Daniel-Wait/EDesign344/README.md

# EDesign344 Analog Electronics

Power Monitoring System.

3rd Year, 2nd semester design project. Read "./Reports/Wait_20887507_A3.pdf" for further details.
