Daniel-Wait/EDesign344/Reports/DanielWait_20887507_Ass2.pdf

## Report for E-design 344

by

## DB Wait

20887507

E-Design report # 2

September 2019

# Declaration

By submitting this report electronically, I declare that the entirety of the work contained therein is my own, original work, that I am the sole author thereof (save to the extent explicitly otherwise stated), that reproduction and publication thereof by Stellenbosch University will not infringe any third party rights and that I have not previously in its entirety or in part submitted it for obtaining any qualifcation.

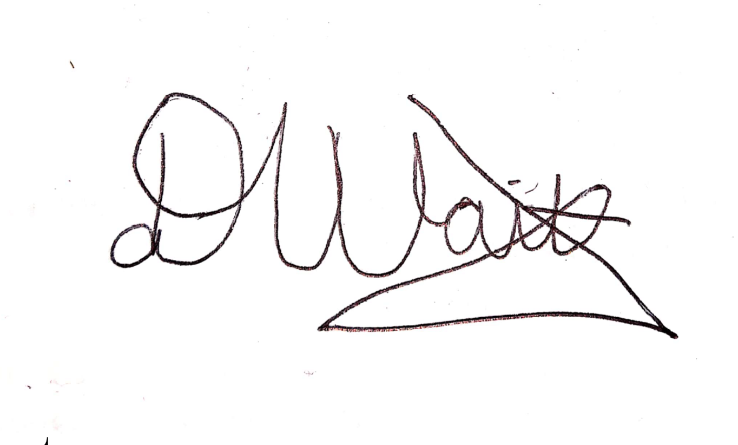
[picture p1: figure]

Signature: | D.B. Wait
Date: |

i

23/09/2019

# Contents

Declaration | i
Contents | ii
List of Figures | iii
1 Signal conditioning system design | 1
2 Voltage peak transducer | 2
3 Current peak transducer | 7
4 Phase shift transducer | 12
5 System tests | 15
References | 17
Appendix A: GitHub Activity Heatmap | 18

ii

# List of Figures

1.1 | System diagram | | 1
2.1 | Voltage Transducer circuit | | 3
2.2 | Voltage Transducer Circuit | | 4
2.3 | Emulated Voltage Transducer tests | | 5
2.4 | Voltage Transducer: Linear function of analogue output vs input voltage 5
2.5 | Integrated test of voltage transducer | | 5
2.6 | Oscilloscope measurement of analogue DC output and AC character-
| istics of the Voltage Transducer for the Mid-range load | | 6
3.1 | Current Transducer circuit | | 7
3.2 | Current transducer LTSpice results | | 9
3.3 | Emulated Voltage Transducer tests | | 9
3.4 | Current Transducer: Linear function of analogue output vs. load current 10
3.5 | Integrated test of the current transducer | | 10
3.6 | Oscilloscope measurement of analogue DC output and AC character-
| istics of the Current Transducer for the Mid-range load | | 11
4.1 | Phase Transducer circuit | | 12
4.2 | LTSpice simulations results | | 13
4.3 | Integrated test of the phase shift transducer | | 14
4.4 | Oscilloscope measurement of analogue DC output and AC character-
| istics of the Phase Transducer for the Mid-range load | | 14
5.1 | Integrated test of the current transducer | | 15
5.2 | Oscilloscope measurements of rails at Full Load Condition | | 16

iii

# Chapter 1

# Signal conditioning system design

The colour-coded block diagram as shown in Figure 1.1 represents the design of the system to transduce the peak voltage (blue) and peak current (yellow) through a load, as well as the absolute phase-shift between them (green). The design is required to measure: an input voltage between 12 VAC to 20 VAC; a current through the load of 0 mA to 285 mA; and an absolute phase-shift of 0° to 45°. Each transducer’s output shall be represented on a 0 V to 5 V, 10-bit ADC.
The 5 V and −5 V rails from Assignment 1 are designed to output at least 50 mA. The system uses 7 TLC2272 op-amps and a TL081 op-amp resulting in a maximum current consumption of 23.8 mA. Therefore, the rails should work.

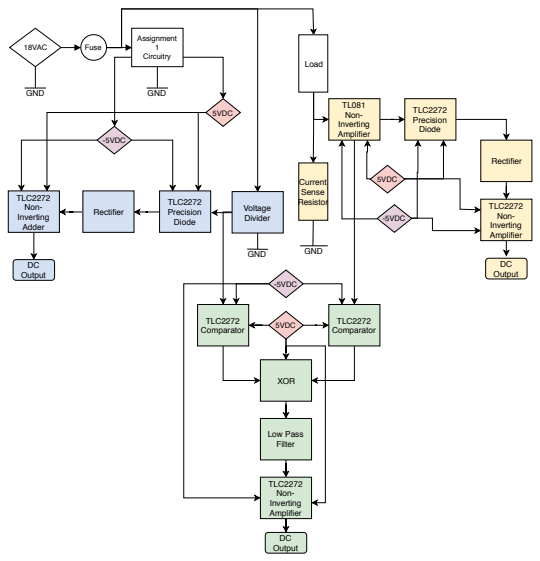
[picture p2: figure]
TLC2272 Precision Diode; Rectifier; TLC2272 Non- Inverting Amplifier; DC Output; 18VAC; Fuse; Assignment 1 Circuitry; GND; 5VDC; -5VDC; TL081 Non- Inverting Amplifier; Load; Current Sense Resistor; Voltage Divider; TLC2272 Non- Inverting Adder; TLC2272 Comparator; XOR; Low Pass Filter

Figure 1.1: System diagram

1

# Chapter 2

# Voltage peak transducer

## 2.1 Theory and related work

In order to transform an AC voltage into a DC voltage output, rectification will be necessary. A simple half-wave rectifier would use a 1N4007 rectifying diode which has a forward-voltage of 1.1 V [1, p.2]. In order to induce a negligible voltage drop over the diode, a ’precision-diode’ configuration is used. The precision-diode functions by using the diode’s cathode as feedback to the op-amp such that the output of the precision-diode matches the positive cycle of the input voltage [2, p.

654] and Vin+ = Vin− = Vout.
For a half-wave rectifier, the Equation 2.1 can be used to calculate the RC constant (τ ) for given parameters [2, p.76]. It is important to note that multiplication of VL and VM by the same factor has no affect on τ .

VL = VMe

−t/τ | (2.1)

This project also implements a non-inverting summing amplifier with two inputs. The output of such a configuration is to be calculated with the following equation [3]:

Vout = (1 + Rf
Rg

)(V1

Rin2

Rin1 + Rin2

+ V1

Rin1

Rin1 + Rin2

) | (2.2)

The supply voltage from the transformer regularly exceeds 18 VAC and may be up to 22 VAC for the no-load condition. Hence, the design parameters have been adjusted for a range of 12 VAC to 23 VAC.

## 2.2 Design

Figure 2.1 is the product of the design choices below.

2

CHAPTER 2. VOLTAGE PEAK TRANSDUCER | 3

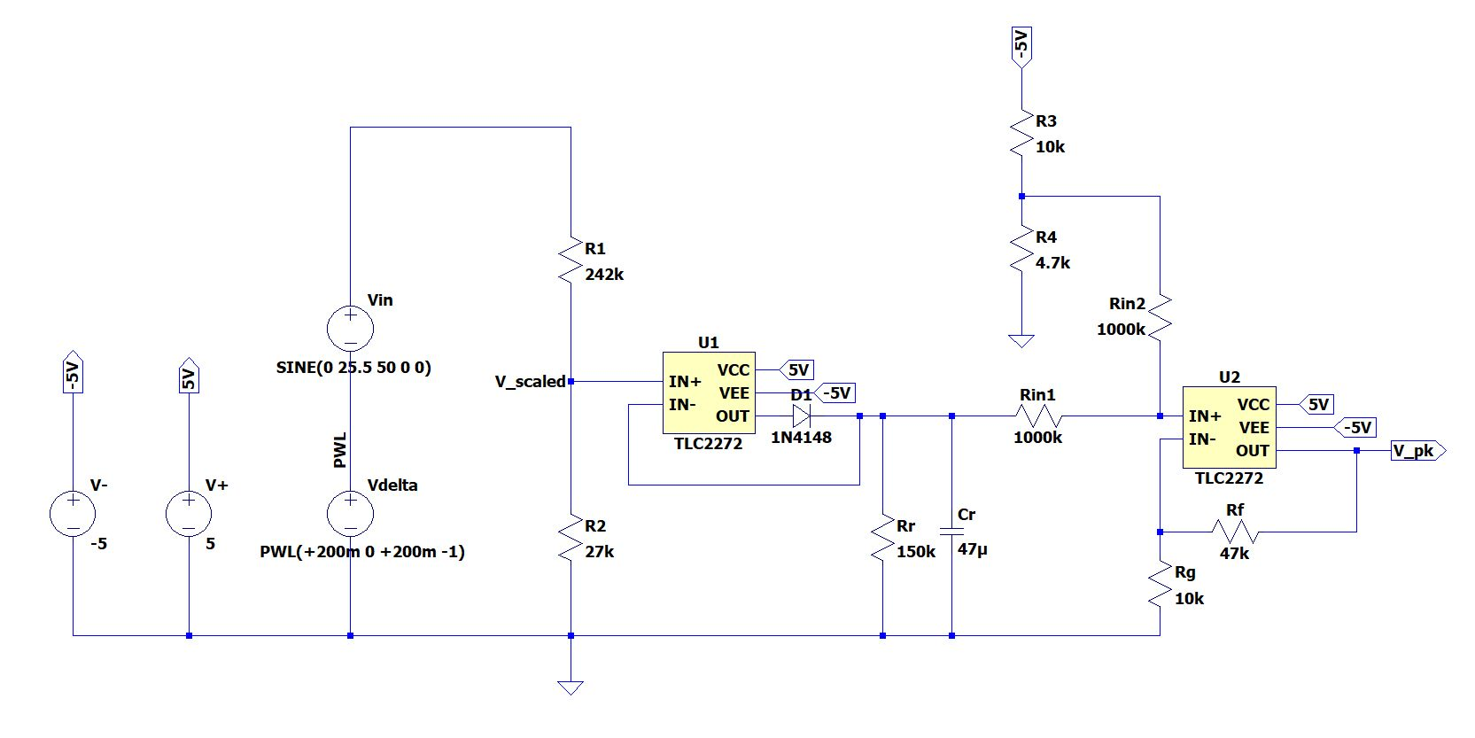
[picture p3: figure]

Figure 2.1: Voltage Transducer circuit

Firstly, the input AC voltage is divided with high-impedance resistors. This scaled voltage is input to the precision diode. To account for the maximum common-mode voltage of the TLC2272, the scaled voltage may be no more than 3.5 V. The transformer output may be as large as 31 Vpk, hence I chose to scale down the input voltage by a factor of 10 so that the common-mode limit will not be exceeded.

1
10 =

R2
R1+R2
Choosing R2 = 27 kΩ to ensure a high series impedance, R1 = 243 kΩ which can be approximated with a series combination of 220 kΩ and 22 kΩ resistors.

Secondly, the scaled voltage is half-wave rectified. The rectified signal ripple must meet the 150 mV accuracy requirement while preserving the ability to detect a 1 V change at the input within one second. Using the given Equation 2.1, the minimum value of τ can be determined such that a 23 VAC drops by 150 mV over a 20 ms period:

τmin =

−0.02
ln( ²³√
2−0.15
23√
2

)

= 4.33

Similarly, for a minimum voltage of 16 VAC, to detect a 1 V decrease within 1 s, the maximum value of τ can be calculated:

τmax =

−1
ln( ¹⁶√
2−1
16√
2

)

= 22.12

Therefore, a resistor of 150 kΩ and a capacitor of 47 µF results in an acceptable τ = RC = 7.05.

CHAPTER 2. VOLTAGE PEAK TRANSDUCER | 4

Finally, the rectified signal is passed to a non-inverting summing amplifier [3] which scales the voltage such that the original input of 12 VAC to 23 VAC lies within a range of 0 VDC to 5 VDC.
The amplifier takes the rectified signal and a DC offset as the inputs - both input resistances are 1 MΩ for simplicity. The negative rail is used to create an offset at the second input of the amplifier such that 12 VAC translates to 0 V. Thus, the negative rail divided with resistors (R3 and R4) to match an input of 12 VAC (divided and rectified to 1.7 V).
The gain of the non-inverting adder is designed so that 23 VAC represents at most 4.85 V in compliance with the minimum high-level output voltage of the TLC2272 for low currents [4, p.7]. Therefore, a gain of 5.7 is chosen with Rf = 47 kΩ and Rg = 10 kΩ

## 2.3 Simulation

The design was validated with an LTSpice simulation to ensure that the design requirements are met. Figure 2.2 is the result of the simulation of the circuit in Figure 2.1. The graphic depicts the scaled voltage, input voltage decrements, and DC voltage output of the voltage transducer for an 18 VAC input.

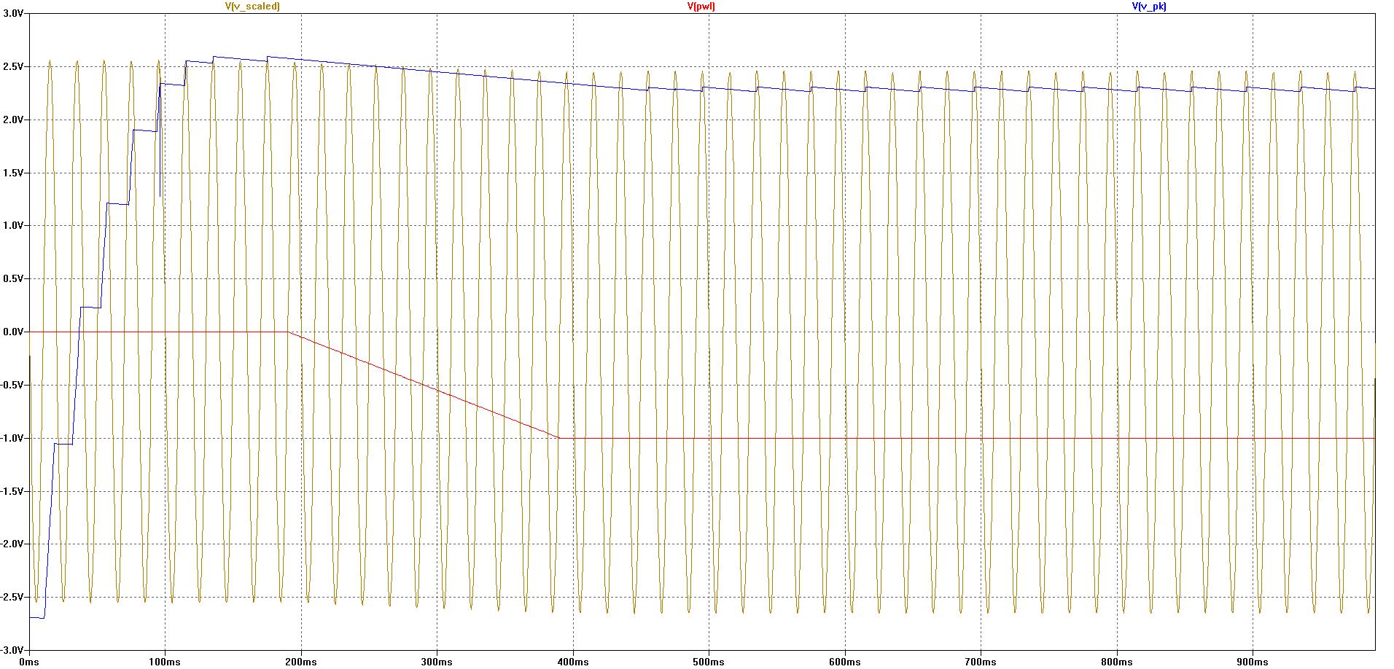
[picture p4: figure]

Figure 2.2: Voltage Transducer Circuit

## 2.4 Measurements

The design was rigorously tested with emulated input voltages in order to determine the accuracy of the deduced input from the analogue output. The deduced input

CHAPTER 2. VOLTAGE PEAK TRANSDUCER | 5

column is calculated from the circuit design to demonstrate the deviation from the expected output.

Figure 2.3: Emulated Voltage Transducer tests

Table 2.3 was used to generate an accurate linear model as shown in Figure 2.4. This model is to be used in the integrated test’s calculation.

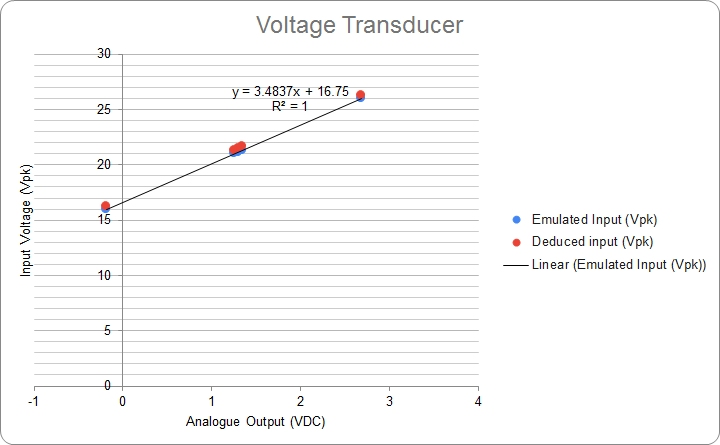
[picture p5: figure]

Figure 2.4: Voltage Transducer: Linear function of analogue output vs input voltage

The integrated test in Figure 2.5 verifies that inaccuracies in the output can be compensated for with the above linear equation.

Figure 2.5: Integrated test of voltage transducer

CHAPTER 2. VOLTAGE PEAK TRANSDUCER | 6

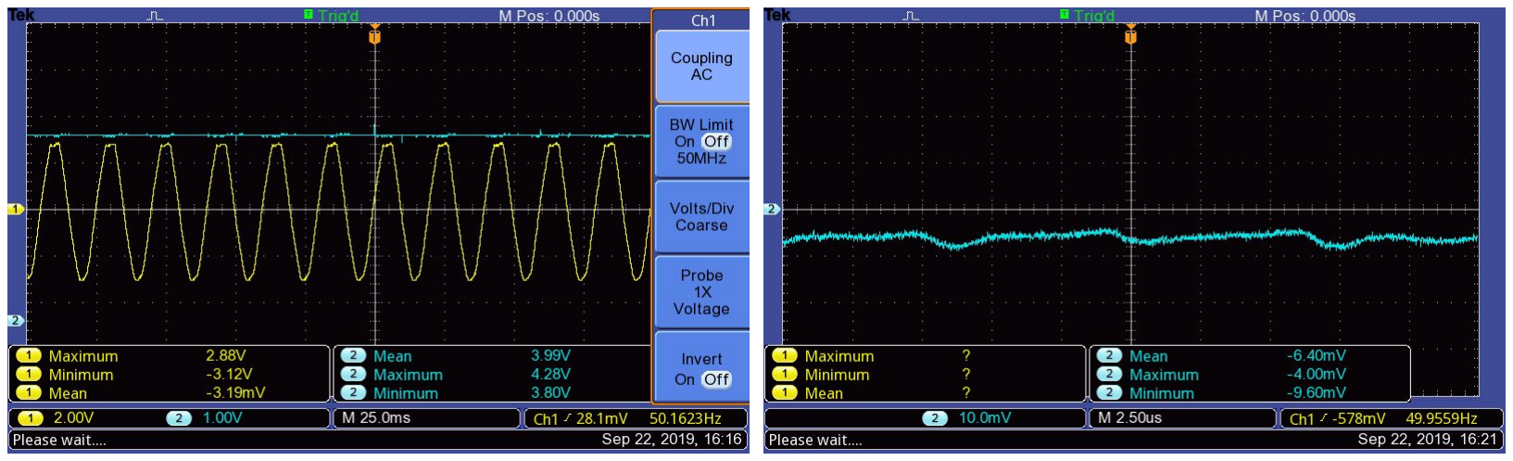
[picture p6: figure]

(a) VAC Input and DC output | (b) Voltage transducer AC output

Figure 2.6: Oscilloscope measurement of analogue DC output and AC characteristics of the Voltage Transducer for the Mid-range load

# Chapter 3

# Current peak transducer

## 3.1 Theory and related work

The current transducer design is quite similar to that of the voltage transducer, due to the nature of transforming an AC signal into a DC representation. Once again, the precision rectifier, equation 2.1, and a precision diode will be used.
A simple, non-inverting amplifier configuration, the gain is calculated as follows:

Av = (1 + Rf
Rg
) | (3.1)

For such configurations, the maximum common-mode voltage is unlikely to be exceeded due to the fact that Vin−max = VOH

Rg
Rf+Rg .
TL081 op-amps have a better Common-Mode Rejection Ratio (CMRR) than that of a TLC2272 [5, p.7] [4, p.7]. Therefore, the TL081 makes for a better smallsignal amplifier [6].

## 3.2 Design

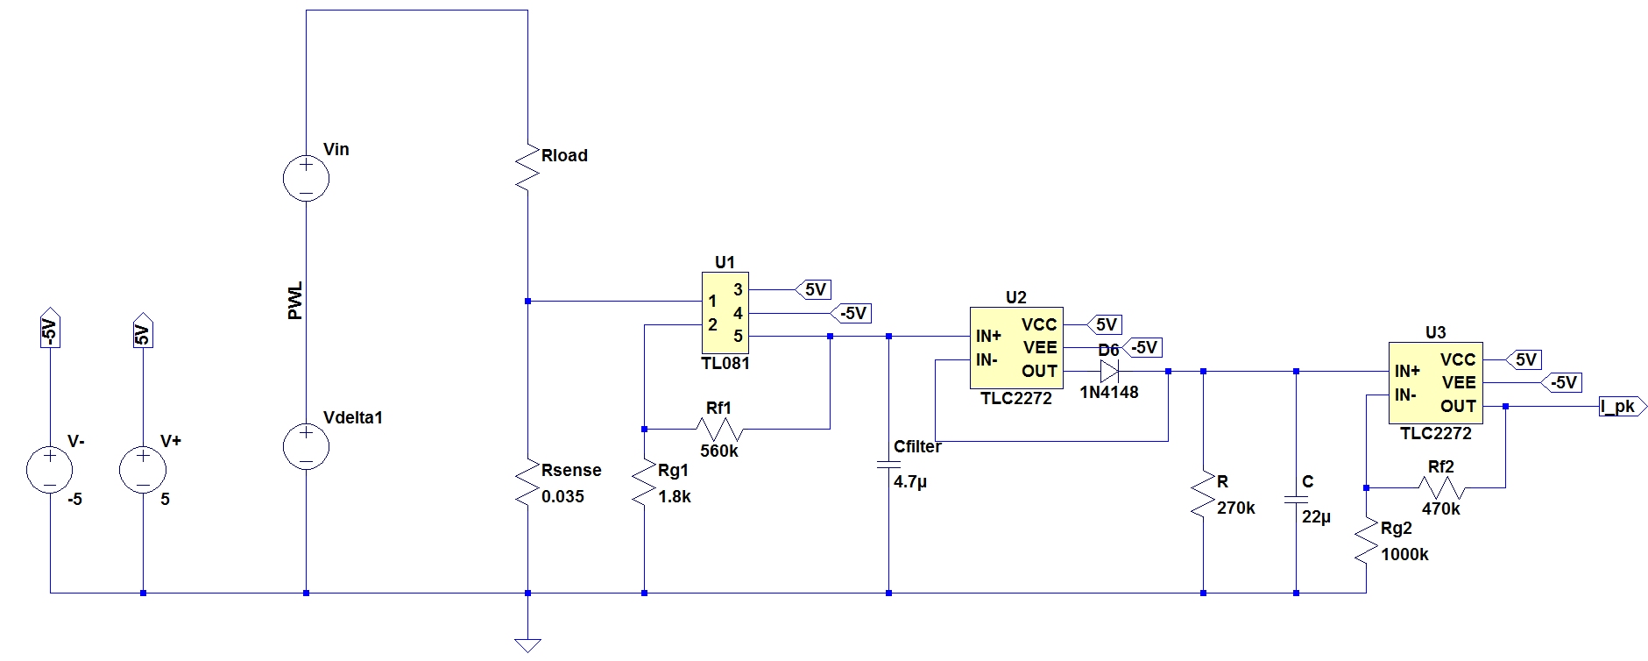
[picture p7: figure]

Figure 3.1: Current Transducer circuit

7

CHAPTER 3. CURRENT PEAK TRANSDUCER | 8

30 mΩ and 5 mΩ current-sense resistors are connected in series to maximize the small voltage which is pre-amplified by the TL081 op-amp. For a maximum current of 285 mA (VRsense = 9.975 mV), the voltage gain is required to comply with the TL081 minimum high-level output voltage of 3.5 V [5, p.9]. A gain of 312 is set by choosing Rf1 = 560 kΩ and Rg1 = 560 kΩ.
The pre-amplified voltage is half-wave rectified. The precision diode ensures negligible voltage drop. The rectified signal ripple must meet the 1 mA accuracy requirement and be able to detect a 10 mA change in current for currents over 100 mA within one second.
The maximum value of τ can be determined such that a 285 mA drops by 1 mA over a 20 ms period:

τmin =

−0.02
ln( ²⁸⁵⁻¹
285 )

= 5.69

Similarly, for a minimum current of 100 mA, to detect a 10 mA decrease within 1 s, the maximum value of τ can be calculated:

τmax =

−1
ln( ¹⁰⁰⁻¹⁰
100 )

= 9.49

Therefore, a resistor of 270 kΩ and a capacitor of 22 µF results in an acceptable τ = RC = 5.94.

The rectified signal is post-amplified by a non-inverting amplifier such that 285 mA through the sensing resistor will output closer to the 5 V limit. Hence, for a configuration of Rf2 = 470 kΩ and Rg2 = 1 MΩ, the gain is 1.47 and an input of 285 mA should be converted to 4.58 V.

## 3.3 Simulation

An LTSpice simulation of the circuit in Figure 3.1 indicates that the current transducer satisfies the specifications. The input voltage is chosen to demonstrate that the chosen RC constant allows a 10 mA change to be detected for currents above 100 mA.

CHAPTER 3. CURRENT PEAK TRANSDUCER | 9

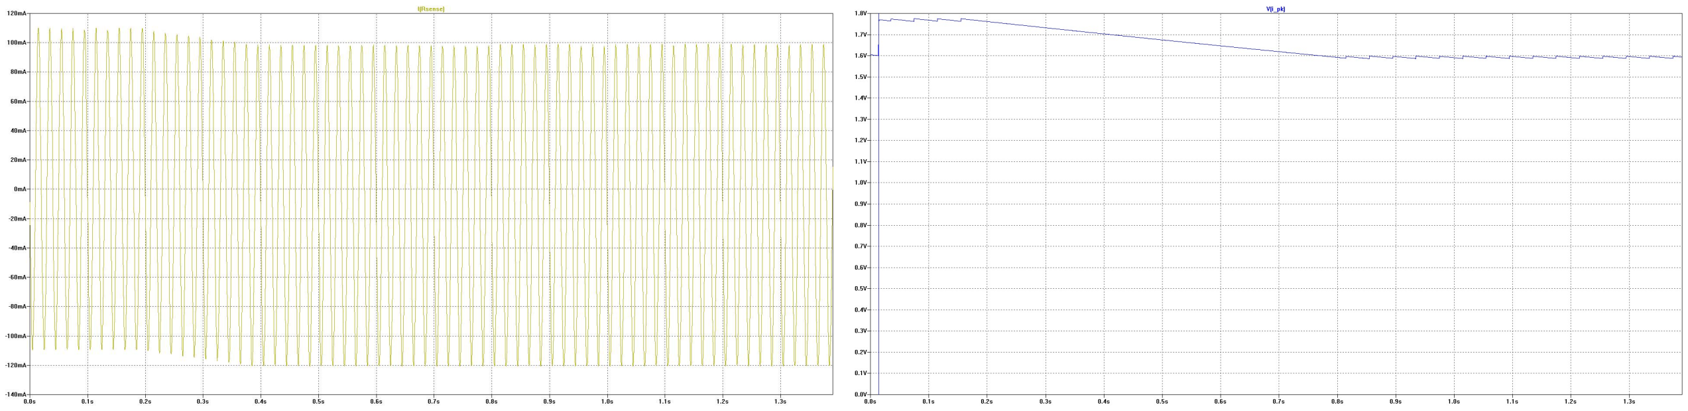
[picture p8: figure]

(a) Decreasing load current | (b) Current transducer DC output

Figure 3.2: Current transducer LTSpice results

## 3.4 Measurements

As with the voltage transducer, emulated tests where performed to determine the functionality of the design and compensate for inaccuracies. Resistors were used to divide the voltage applied to the system. The selected and measured function generator outputs differed considerably due to noise.

Figure 3.3: Emulated Voltage Transducer tests

Due to the difficulties of emulating the load current, the linear function of the deduced input is more reliable for calculations. The linear function is given in Figure 3.4.

CHAPTER 3. CURRENT PEAK TRANSDUCER | 10

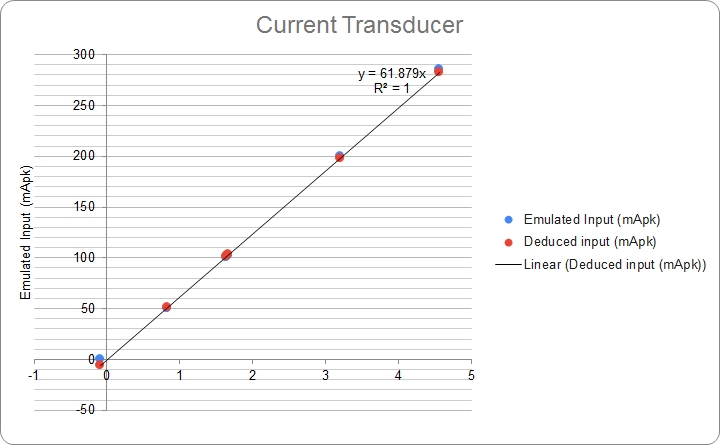
[picture p9: figure]

Figure 3.4: Current Transducer: Linear function of analogue output vs. load current

By applying the linear function in Figure 3.4 for the integrated tests, a marginally accurate calculation of the load current is achievable. The voltage drop over the sense resistors is indeterminate so the best I could do to determine the actual current in the system was to divide the measured input voltage by the load impedance.

Figure 3.5: Integrated test of the current transducer

CHAPTER 3. CURRENT PEAK TRANSDUCER | 11

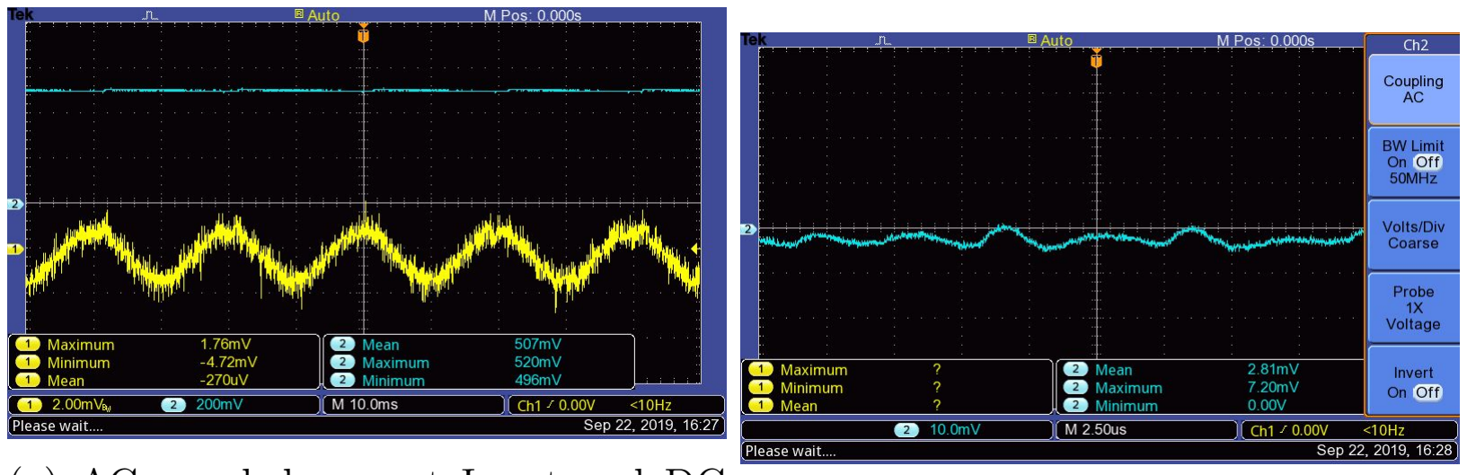
[picture p10: figure]

(a) AC coupled current Input and DC
output
(b) Current transducer AC output

Figure 3.6: Oscilloscope measurement of analogue DC output and AC characteristics of the Current Transducer for the Mid-range load

# Chapter 4

# Phase shift transducer

## 4.1 Theory and related work

This design converts a PWM signal into a DC signal using a first-order low-pass passive filter. A PWM signal can be described as a Fourier series of sinusoidal signals. Essentially, a very small corner frequency is selected so that only the 0 Hz portion remains.
A series capacitor and parallel resistor which acts as a high-pass filter uses the inverse method to enable accurate phase detection.
The corner frequency of these filters can be determined with Equation 4.1.

fc =

1
2πRC | (4.1)

## 4.2 Design

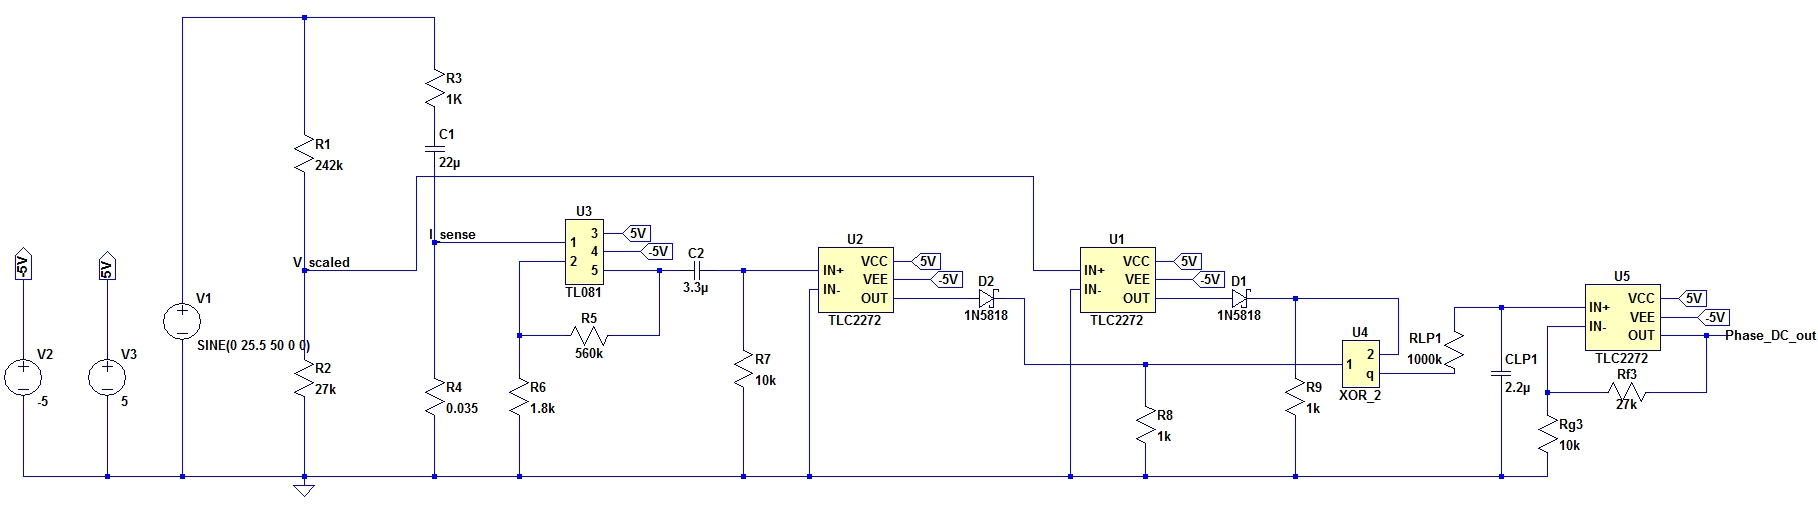
[picture p11: figure]

Figure 4.1: Phase Transducer circuit

The transducer converts the voltage and amplified current sinusoidal signals into square waves using a comparator configuration referenced to ground such that it

12

CHAPTER 4. PHASE SHIFT TRANSDUCER | 13

acts as a ’zero-crossing detector’. The TLC2272 op-amp was used for the comparators due to its high maximum common-mode voltage and large minimum high-level output voltage.
Due to intrinsic offsets in the amplified current signal, a high pass filter is used before the current comparator such that the corner frequency is much smaller than 50 Hz. Hence, for R = 10 kΩ and C = 3.3 µF: fc = 4.8Hz.
The comparator outputs are passed through an XOR gate to obtain a PWM which represents the phase shift between the voltage and current. due to the fact that XOR gate minimum input voltage is −0.5 V [7, p.4], the negative portion of the comparator outputs is blocked by diodes. Schottky diodes are used for the benefit of a low forward-voltage.
The PWM signal is filtered by the low-pass filter such that the lowest frequency components remain. For R = 1 MΩ and C = 2.2 µF: fc = 0.07Hz
For a PWM of 0 V to 5 V, the maximum phase shift of 45° results in a DC value of 1.25 V. For better resolution, a gain of 4 is desired. The DC voltage is amplified by a non-inverting TLC2272 amplifier. According to Equation 3.1, by selecting resistors Rf3 = 27 kΩ and Rg3 = 10 kΩ a gain of 3.7 is induced.

## 4.3 Simulation

LTSpice simulations of the deigned circuit produce a satisfactory output, albeit noisy. The cause of the noise could not be determined and does not appear in the practical implementation.

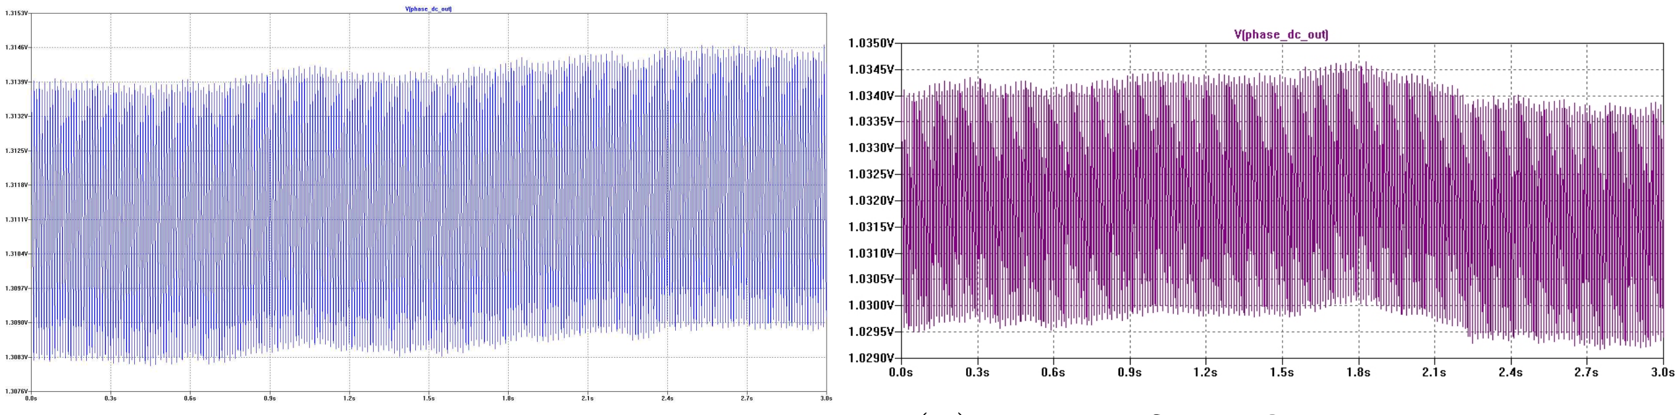
[picture p12: figure]

(a) Mid: 1 kΩ and 22 µF load | (b) Mid + δ: 1 kΩ and 33 µF load

Figure 4.2: LTSpice simulations results

## 4.4 Measurements

For 1° accuracy, the difference between deduced the deduced and actual input may be no more than 1°
360°

20 ms = 55.56 µs. Therefore, calculating the input phase shift

CHAPTER 4. PHASE SHIFT TRANSDUCER | 14

based on the circuit design proves sufficient for the integrated tests.

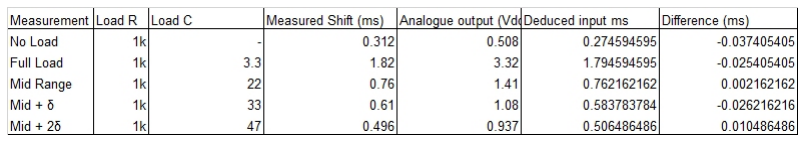
[picture p13: figure]

Figure 4.3: Integrated test of the phase shift transducer

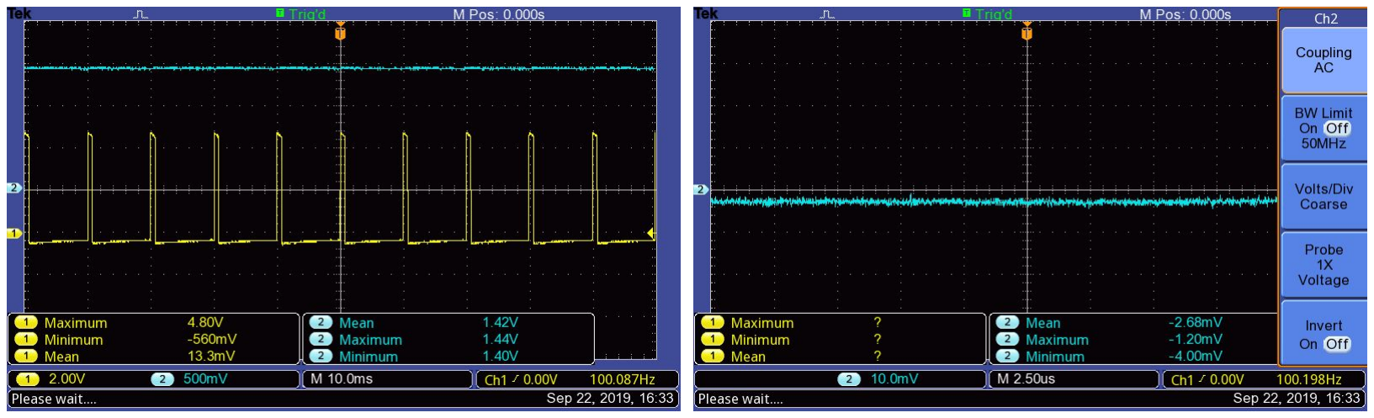
[picture p14: figure]

(a) PWM and DC output | (b) Phase transducer AC output

Figure 4.4: Oscilloscope measurement of analogue DC output and AC characteristics of the Phase Transducer for the Mid-range load

# Chapter 5

# System tests

The circuit in Figure 5.1 is testament to the arduous task of building, testing, and tweaking to meet the requirements.

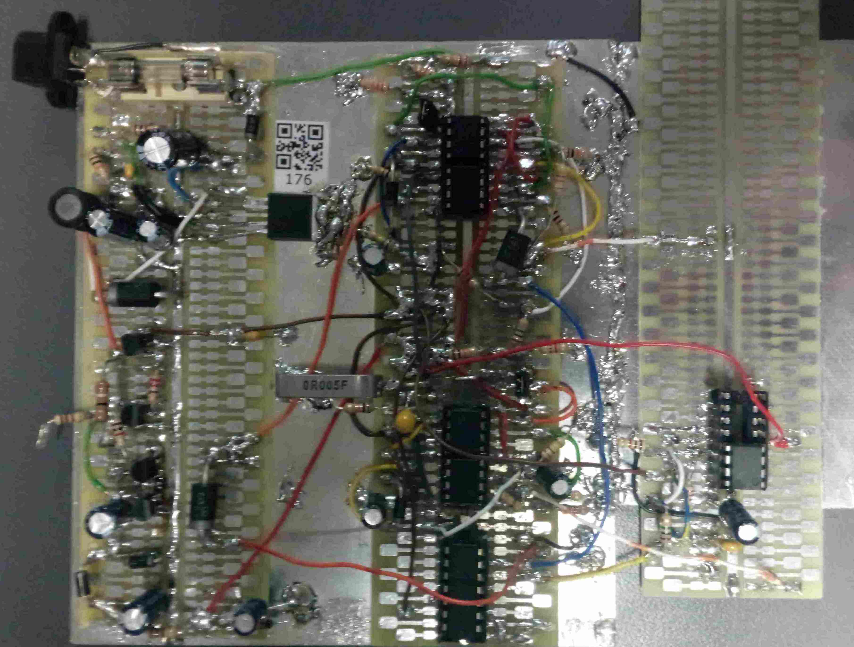
[picture p15: figure]

Figure 5.1: Integrated test of the current transducer

15

CHAPTER 5. SYSTEM TESTS | 16

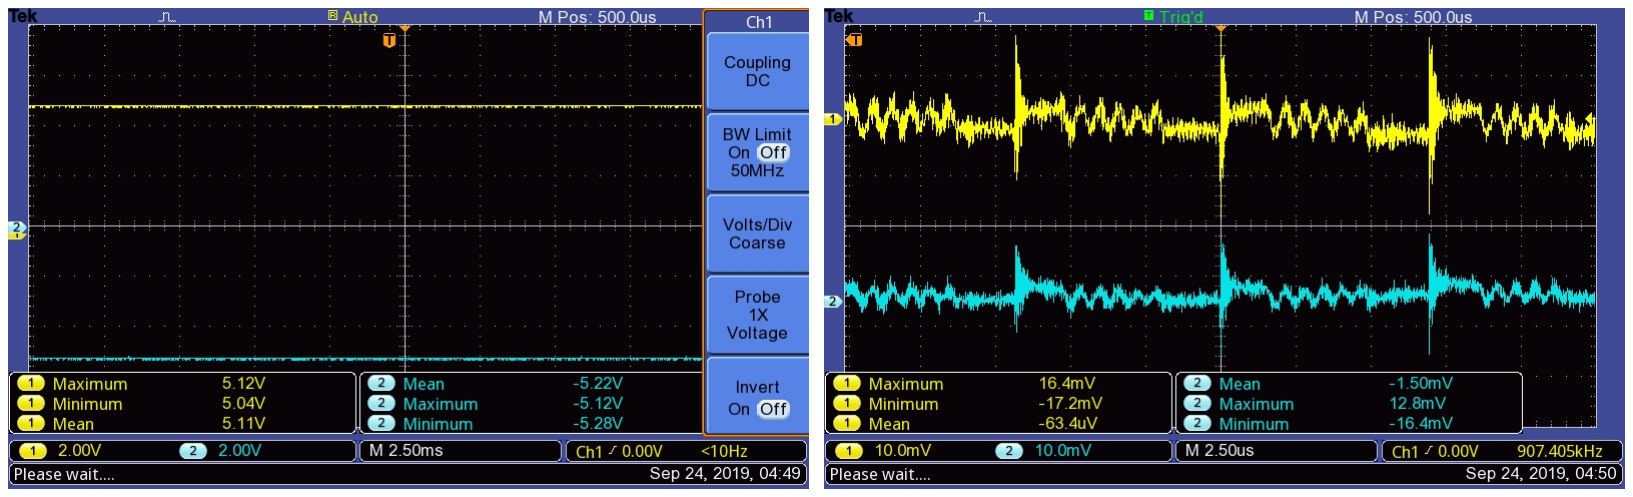
[picture p16: figure]

(a) DC rails | (b) AC rails

Figure 5.2: Oscilloscope measurements of rails at Full Load Condition

# References

[1] 1N4001-1N4007 General-Purpose Rectifiers. Fairchild Semiconductor, 2014.
[2] Neamen, D.A.: Microelectronics. McGraw Hill, 2010.
[3] ELECTRONICS HUB: Summing amplifier. 2019.
Available at: https://www.electronicshub.org/summing-amplifier/
[4] TLC227x, TLC227xA: Advanced LinCMOS Rail-to-Rail Operational Amplifiers. Texas Instruments, 1977.
[5] TL08xx JFET-Input Operational Amplifiers. Texas Instruments, 1977.
[6] Gerard Fonte: How to choose an operational amplifier. 2008.
Available at: https://www.nutsvolts.com/magazine/article/howtochooseanoperationalamplif ier
[7] CD4070B, CD4077B CMOS Quad Exclusive-OR and Exclusive-NOR Gate. Texas Instruments, 1998.

17

# Appendix A: GitHub Activity Heatmap

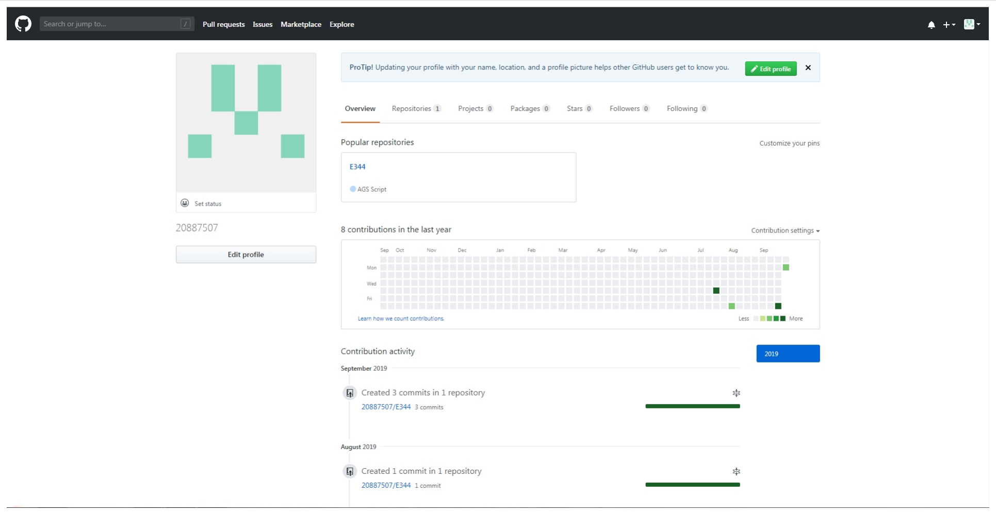
[picture p17: figure]

18
