Daniel-Wait/EDesign344/LTSpice/-5V_charge-pump.asc

220u: cap; 100µ
C1: cap; 100µ
C2: cap; 47µ
D1: diode; 1N4148
D2: diode; 1N4148
Q1: npn; 2N3904
Q2: npn; 2N3904
Q3: npn; 2N3904
R1: res; 10
R2: res; 1k
R3: res; 220
R4: res; 100
R5: res; 39
R6: res; 1k
U2: 1N4733A
V1: voltage; PULSE(0 5 0 0.00005 0.00005 0.0002 0.0005)
V2: voltage; 14
Named nets: 0
.tran 0 0.2 0 0.1
.lib "C:\\Users\\Daniel\\Documents\\university\\3rd year\\2) E-Design 344\\SPICE models\\1N4733A.lib"
