Daniel-Wait/EDesign344/LTSpice/20887507_E344_FullSystem.asc

C1: cap; 220µ
C2: cap; 120µ
C3: cap; 4.7n
C4: cap; 100µ
C5: cap; 100µ
C6: cap; 47µ
C7: cap; 47µ
C8: cap; 47µ
C9: cap; 3.3µ
C10: cap; 4.7µ
Cload: cap; 22µ
Clp1: cap; 2.2µ
D1: diode; 1N4148
D2: schottky; 1N5819
D3: diode; 1N4148
D4: diode; 1N4148
D5: diode; 1N4148
D6: diode; 1N4007
D7: diode; 1N4148
D8: schottky; 1N5818
D9: schottky; 1N5818
L1: ind; 68µ
Q1: npn; 2N3904
Q2: npn; 2N3904
Q3: npn; 2N3904
Q4: npn; 2N3904
Q5: npn; 2N3904
Q7: npn; 2N3904
R1: res; 6.8k
R2: res; 1k
R5: res; 10
R6: res; 1k
R7: res; 1k
R8: res; 220
R9: res; 39
R10: res; 150k
R11: res; 10k
R12: res; 47k
R13: res; 10k
R14: res; 4.7k
R15: res; 1000k
R16: res; 1000k
R17: res; 1k
R18: res; 1k
R19: res; 10k
R20: res; 12k
R21: res; 1.8k
R22: res; 560k
R23: res; 100K
R24: res; 1000k
R25: res; 470k
R26: res; 22k
R27: res; 1k
R28: res; 1k
R29: res; 10k
R30: res; 10k
R31: res; 10k
R32: res; 10k
R33: res; 10k
R34: res; 100k
R35: res; 100k
R38: res; 220
Rdiv1: res; 242k
Rdiv2: res; 27k
Rf1: res; 27k
Rg1: res; 10k
Rload: res; 1K
RLP1: res; 1000k
Rsense: res; 0.035
U1: LM2595_ADJ_TRANS
U2: LM7805
U4: TLC2272
U5: TLC2272
U6: TLC2272
U7: TLC2272
U8: TL081
U9: XOR_2
U10: TLC2272
U11: TLC2272
U12: TLC2272
U13: TLC2272
U14: 1N4733A
U15: MOC3020
V1: voltage; SINE(0 25 50)
V2: voltage; PULSE(0 5 0 0.00005 0.00005 0.0002 0.0005)
V5: voltage; PULSE(0 5 0 2m 2m 500m 1)
Named nets: 0, -5V, 5V, V_pk, 14V, Vin, I_pk, V_scaled, I_sense, Phase_DC_out, I_preamp, I_comp, V_comp, SET, RESET, Q, notQ
.tran 2
.lib "H:\\EDesign 344\\LTSpice\\MOC302x.lib"
.lib "H:\\EDesign 344\\LTSpice\\TLC2272.LIB"
.lib "H:\\EDesign 344\\LTSpice\\TL081.lib"
.lib "H:\\EDesign 344\\LTSpice\\LM2595_ADJ_TRANS.LIB"
.lib "H:\\EDesign 344\\LTSpice\\LM78XX_RS.lib"
