Daniel-Wait/EDesign344/LTSpice/5V_rect_switch_lin.asc

C1: cap; 220µ
C2: cap; 120µ
C3: cap; 4.7n
D1: diode; 1N4148
D2: schottky; 1N5819
L1: ind; 68µ
R1: res; 50
R2: res; 6.8k
R3: res; 1k
U3: LM2595_ADJ_TRANS
U4: LM7805
V1: voltage; SINE(0 25 50)
Named nets: 0
.tran 0 0.1 0.01 0.01
.lib "C:\\Users\\Daniel\\Documents\\university\\3rd year\\2) E-Design 344\\SPICE models\\LM2595_ADJ_TRANS.LIB"
.lib "C:\\Users\\Daniel\\Documents\\university\\3rd year\\2) E-Design 344\\SPICE models\\LM78XX_RS.lib"
.lib "C:\\Users\\Daniel\\Documents\\university\\3rd year\\2) E-Design 344\\SPICE models\\1N4733A.lib"
