Daniel-Wait/EDesign344/LTSpice/CurrentTransducer.asc

C4: cap; 47µ
D6: diode; 1N4148
R3: res; 1000k
R4: res; 470k
R5: res; 250
R6: res; 0.035
R7: res; 1.8k
R8: res; 560k
R16: res; 100K
U1: TLC2272
U4: TLC2272
U5: TL081
V1: voltage; SINE(0 25.5 50)
V2: voltage; -5.2
V3: voltage; 5
V4: voltage; PWL(+200m 0 +200m -1)
Named nets: 0, 5V, -5V, I_pk
.tran 0 1 0.01 0.01
.lib "C:\\Users\\Daniel\\Documents\\university\\3rd year\\2) E-Design 344\\SPICE models\\TLC2272.LIB.txt"
.lib "C:\\Users\\Daniel\\Documents\\university\\3rd year\\2) E-Design 344\\SPICE models\\TL081.lib"
