Daniel-Wait/EDesign344/LTSpice/PhaseTransducer.asc

C1: cap; 22µ
C2: cap; 3.3µ
Clp: cap; 2.2µ
D1: schottky; 1N5818
D2: schottky; 1N5818
R1: res; 242k
R2: res; 27k
R3: res; 1K
R4: res; 0.035
R5: res; 560k
R6: res; 1.8k
R7: res; 10k
R8: res; 1k
R9: res; 1k
Rf3: res; 27k
Rg3: res; 10k
RLP1: res; 1000k
U1: TLC2272
U2: TLC2272
U3: TL081
U4: XOR_2
U5: TLC2272
V1: voltage; SINE(0 25.5 50 0 0)
V2: voltage; -5
V3: voltage; 5
Named nets: 0, I_sense, V_scaled, 5V, -5V, Phase_DC_out
.tran 0 20 17
