Daniel-Wait/EDesign344/LTSpice/switch.asc

Q1: npn; 2N3904
Q2: npn; 2N3904
Q3: npn; 2N3904
R1: res; 1k
R2: res; 12k
R3: res; 100k
R4: res; 1k
R5: res; 10k
R6: res; 10k
R7: res; 100k
R8: res; 1K
R9: res; 10k
R10: res; 10k
R11: res; 10k
R12: res; 220
R13: res; 22k
U1: MOC3020
U2: TLC2272
V1: voltage; 5
V2: voltage; 5
V3: voltage; 14
V4: voltage; PULSE(0 5 0 2m 2m 500m 1)
V5: voltage; SINE(0 20 50)
V8: voltage; PULSE(0 1 0 2m 2m 20m 500m)
Named nets: 0, 5V, -5V, 14V, RESET, SET, Q, notQ
.tran 1
.lib "H:\\EDesign 344\\LTSpice\\MOC302x.lib"
.inc "H:\\EDesign 344\\LTSpice\\TLC2272.LIB"
