Daniel-Wait/EDesign344/LTSpice/VoltageTransducer.asc

C1: cap; 47µ
D1: diode; 1N4148
D2: diode
R1: res; 27k
R2: res; 242k
R3: res; 8.2k
R4: res; 150k
R5: res; 10k
R6: res; 47k
R7: res; 4.7k
R8: res; 1000k
R9: res; 1000k
U1: TLC2272
U2: TLC2272
V1: voltage; SINE(0 31.2 50 0 0)
V2: voltage; -5
V3: voltage; 5
V4: voltage; PWL(+200m 0 +200m -1)
Named nets: 0, 5V, -5V, V_pk
.tran 0 1 0.01 0.01 startup
.lib "C:\\Users\\Daniel\\Documents\\university\\3rd year\\2) E-Design 344\\SPICE models\\TLC2272.LIB.txt"
.lib "C:\\Users\\Daniel\\Documents\\university\\3rd year\\2) E-Design 344\\SPICE models\\1N4733A.lib"
